wifijt/POE-Power-buck/docs/board_layers.png

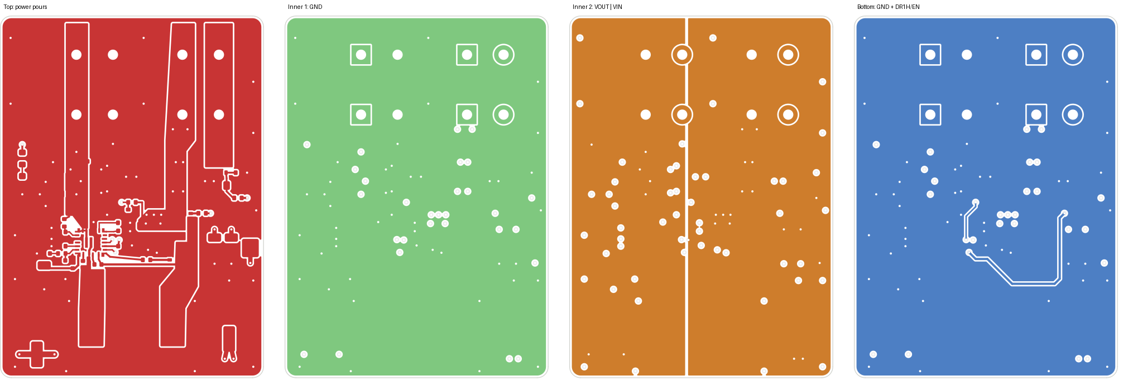
docs/board_layers.png
