wifijt/POE-Power-buck/fab/BOM_JLCPCB.csv

Comment | Designator | Footprint | JLCPCB Part # | MPN | Qty
100uF 35V polymer | C1,C20 | SMD,D6.3xL7.7mm | C46550467 | MA35V100M6X8 | 2
10uF 50V X5R | C2,C3,C4,C5 | 1206 | C13585 | CL31A106KBHNNNE | 4
100nF 50V | C7,C8,C9,C15,C21 | 0402 | C307331 | CL05B104KB54PNC | 5
10nF | C11,C12 | 0402 | C15195 | CL05B103KB5NNNC | 2
100pF C0G | C13 | 0402 | C1546 | 0402CG101J500NT | 1
22uF 25V | C14 | 1206 | C12891 | CL31A226KAHNNNE | 1
22uF 25V X7R | C16,C17,C18,C19 | 1210 | C21397 | GRM32ER71E226KE15L | 4
SMBJ16A | D1 | SMB(DO-214AA) | C19077571 | SMBJ16A | 1
GREEN | D2 | 0603 | C12624 | KT-0603G | 1
BZT52C12 | D3 | SOD-123 | C19077410 | BZT52C12 | 1
6.8uH 20A | L1 | SMD,13.5x12.8mm | C41422303 | ZEMS1265-6R8M | 1
CSD17577Q3A | Q1,Q2,Q3 | VSONP-8(3.3x3.3) | C201632 | CSD17577Q3A | 3
1R | R1,R2 | 0402 | C25086 | 0402WGF100KTCE | 2
100k | R3,R6,R13 | 0402 | C25741 | 0402WGF1003TCE | 3
28.7k | R4 | 0402 | C26972 | 0402WGF2872TCE | 1
49.9k | R5 | 0402 | C25897 | 0402WGF4992TCE | 1
11k | R7 | 0402 | C25749 | 0402WGF1102TCE | 1
22.1k | R9 | 0402 | C43473 | 0402WGF2212TCE | 1
15k | R10 | 0402 | C25756 | 0402WGF1502TCE | 1
4.7k | R11 | 0603 | C23162 | 0603WAF4701T5E | 1
10k | R12 | 0402 | C25744 | 0402WGF1002TCE | 1
TPS552882RPMR | U1 | VQFN-26-HR(4x3.5) | C3188898 | TPS552882RPMR | 1
