wifijt/POE-Power-buck/fab/BOM_hand_solder.csv

Designator | Part | Qty | Note
J1,J2 | WAGO 2604-3102 | 2 | 2-pole 5.0 mm lever terminal, solder by hand after PCBA
