wifijt/POE-Power-buck/enclosure/case_lid.stl

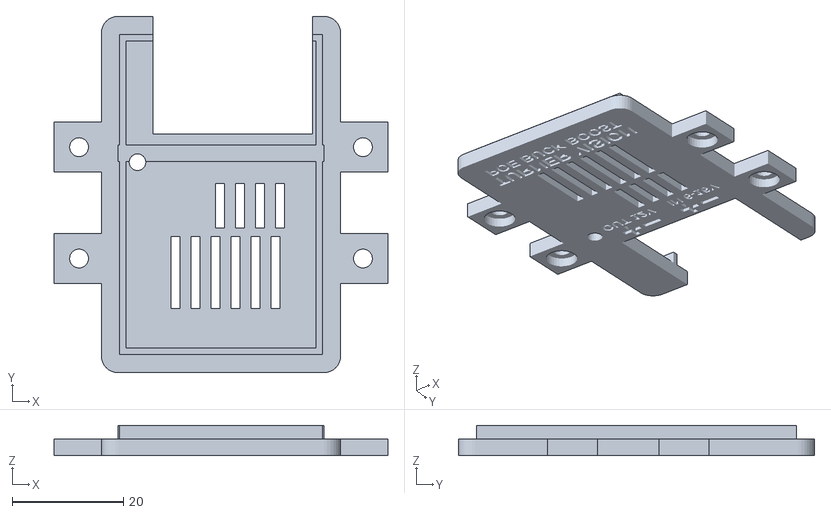
[picture p5: CAD file, 2026-11-11]
enclosure/case_lid.stl
60.0 x 64.0 x 5.40
