wifijt/POE-Power-buck/enclosure/case_tray.stl

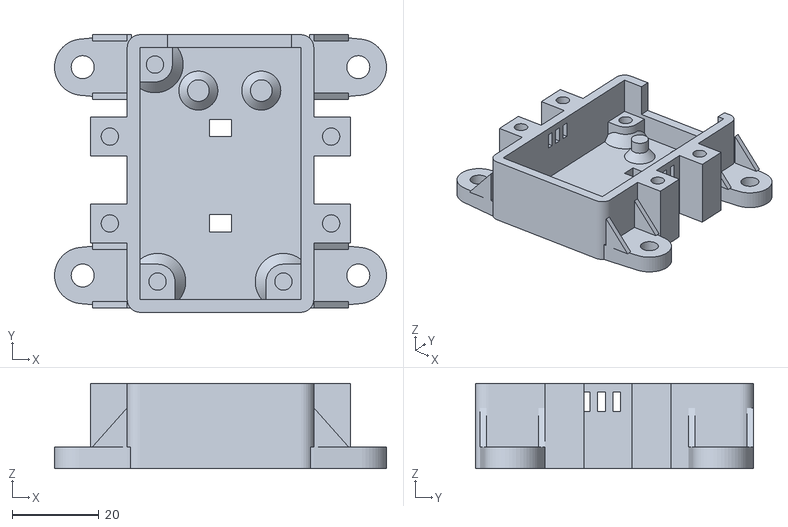
[picture p6: CAD file, 2026-11-11]
enclosure/case_tray.stl
76.5 x 64.0 x 19.6
