wifijt/POE-Power-buck/docs/schematic.pdf

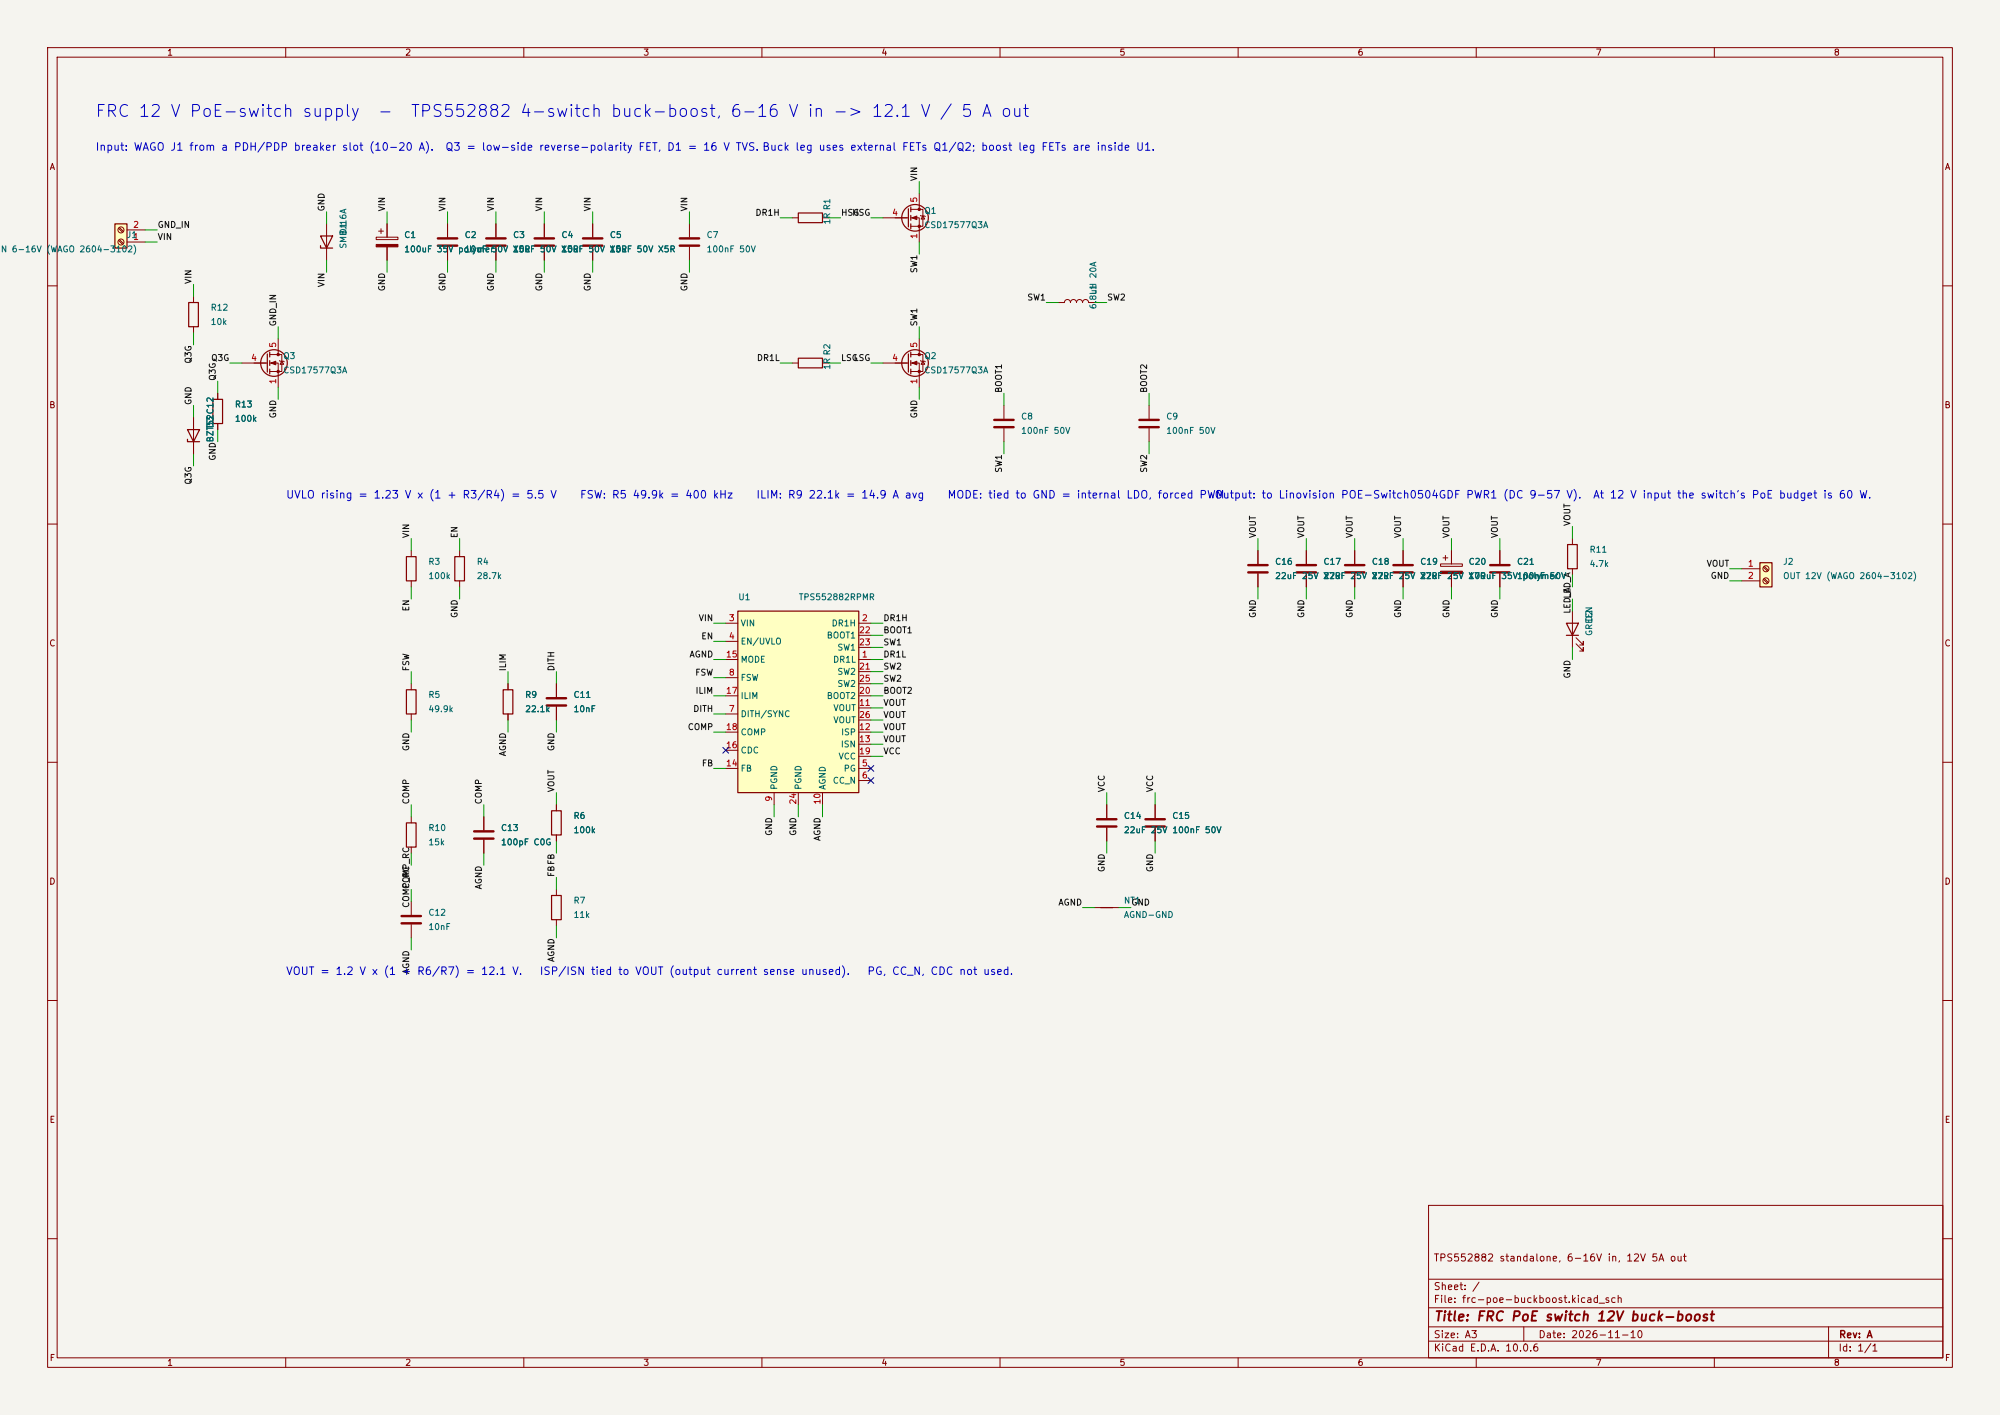
[picture p7: page 1]

FRC 12 V PoE-switch supply - TPS552882 4-switch buck-boost, 6-16 V in -> 12.1 V / 5 A out

Buck leg uses external FETs Q1/Q2; boost leg FETs are inside U1.

Sheet: /
File: frc-poe-buckboost.kicad_sch
Title: FRC PoE switch 12V buck-boost

Size: A3 | Rev: A | F Date: 2026-11-10
KiCad E.D.A. 10.0.6 | Id: 1/1
