wifijt/POE-Power-buck/frc-poe-buckboost.kicad_pcb

## KiCad design frc-poe-buckboost.kicad_pcb (2026-11-11)

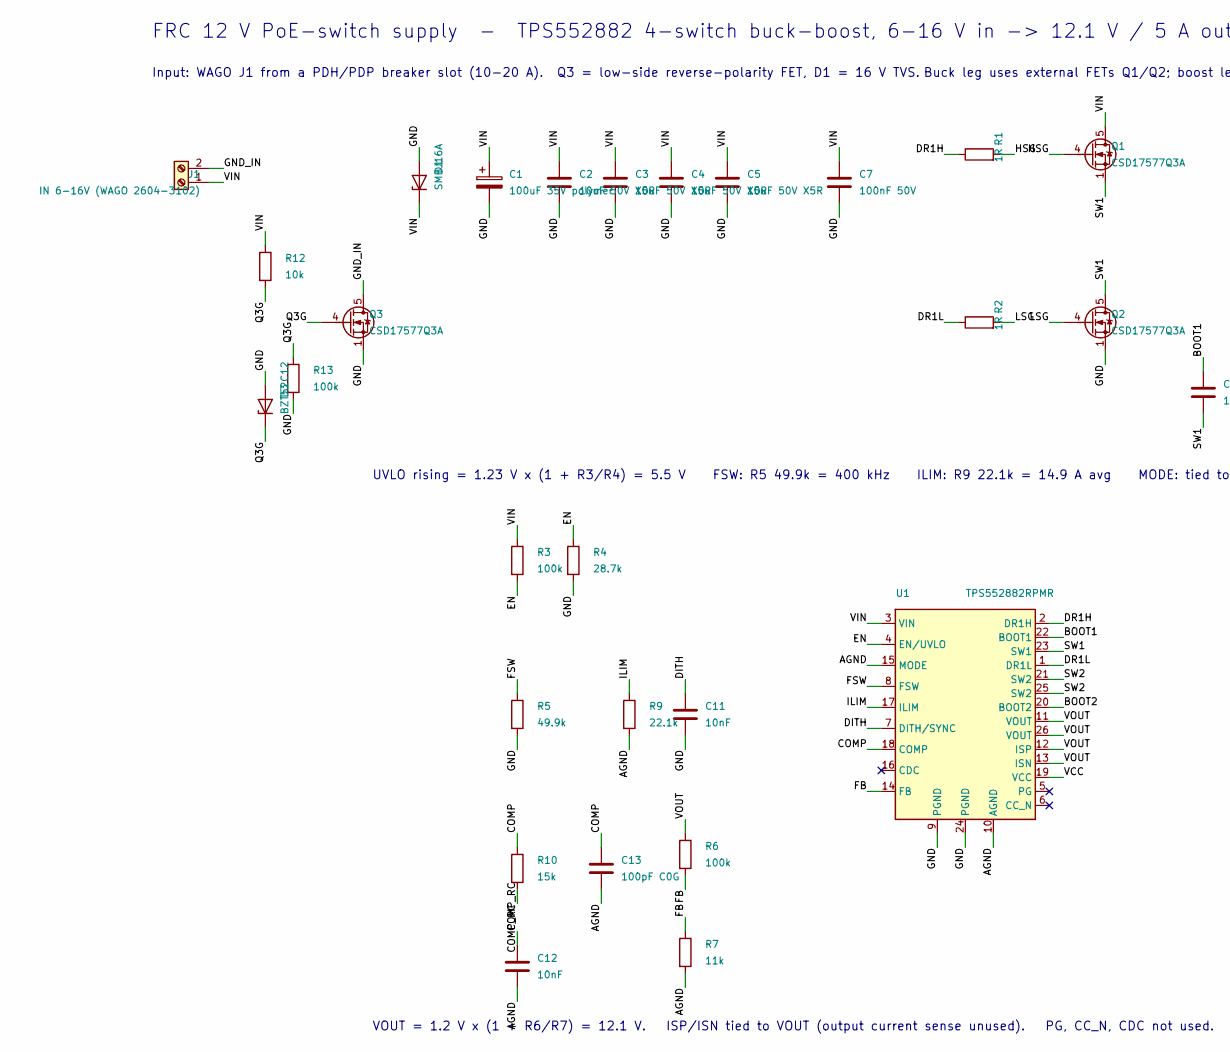
[picture p8: schematic frc-poe-buckboost.kicad_sch, FRC PoE switch 12V buck-boost, part in row 1, column 1]

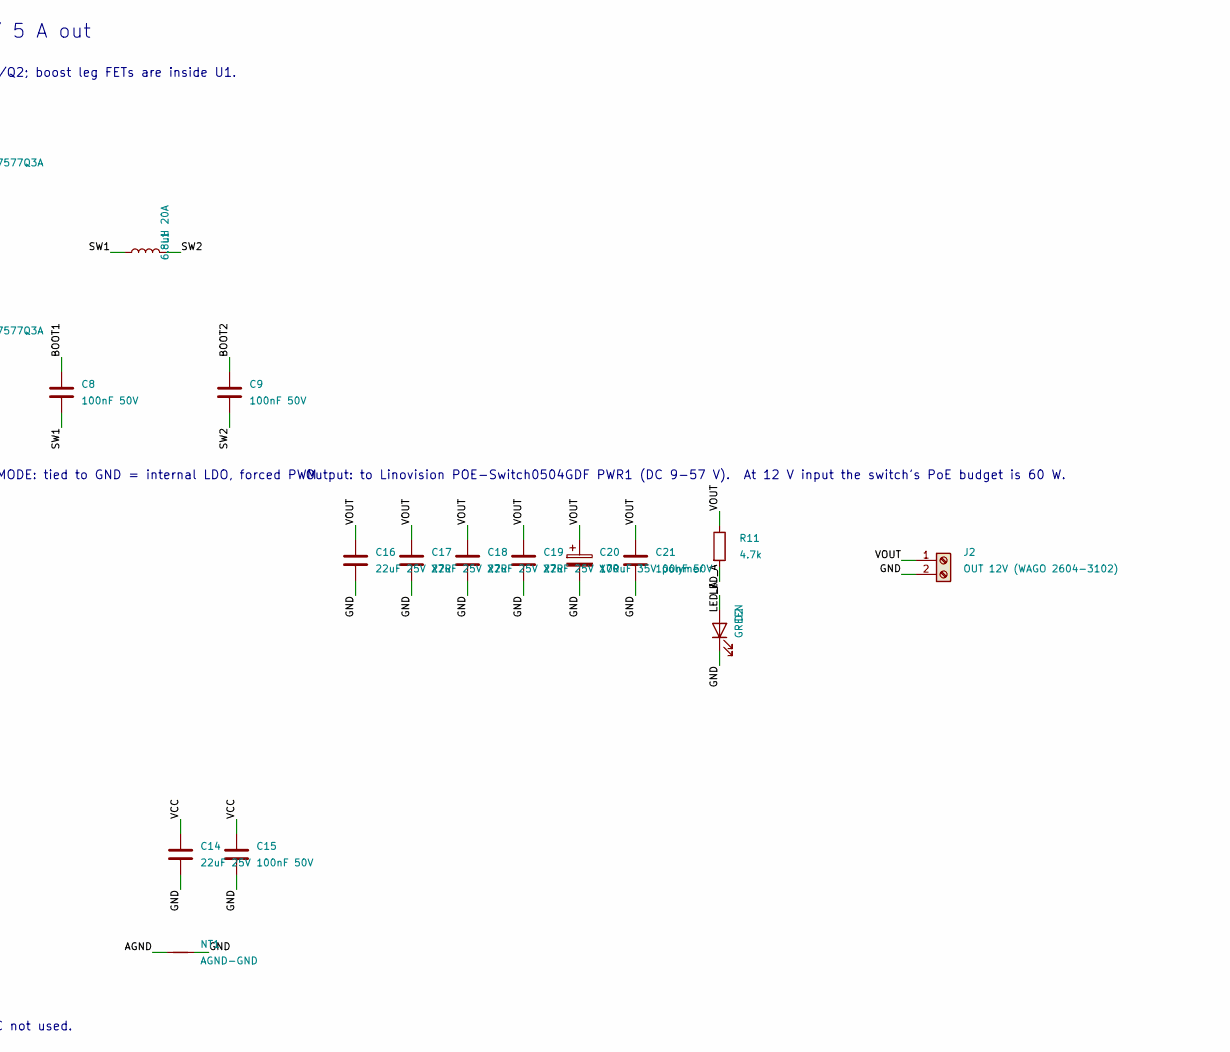
[picture p9: schematic frc-poe-buckboost.kicad_sch, FRC PoE switch 12V buck-boost, part in row 1, column 2]

Parts:
C1, C20: 100uF 35V polymer; CP_Elec_6.3x7.7; MPN MA35V100M6X8; LCSC C46550467
C2, C3, C4, C5: 10uF 50V X5R; C_1206_3216Metric; MPN CL31A106KBHNNNE; LCSC C13585
C7, C8, C9, C15, C21: 100nF 50V; C_0402_1005Metric; MPN CL05B104KB54PNC; LCSC C307331
C11, C12: 10nF; C_0402_1005Metric; MPN CL05B103KB5NNNC; LCSC C15195
C13: 100pF C0G; C_0402_1005Metric; MPN 0402CG101J500NT; LCSC C1546
C14: 22uF 25V; C_1206_3216Metric; MPN CL31A226KAHNNNE; LCSC C12891
C16, C17, C18, C19: 22uF 25V X7R; C_1210_3225Metric; MPN GRM32ER71E226KE15L; LCSC C21397
D1: SMBJ16A; D_SMB; MPN SMBJ16A; LCSC C19077571
D2: GREEN; LED_0603_1608Metric; MPN KT-0603G; LCSC C12624
D3: BZT52C12; D_SOD-123; MPN BZT52C12; LCSC C19077410
J1: IN 6-16V (WAGO 2604-3102); WAGO_2604-3102_1x02_P5.00mm; MPN WAGO 2604-3102
J2: OUT 12V (WAGO 2604-3102); WAGO_2604-3102_1x02_P5.00mm; MPN WAGO 2604-3102
L1: 6.8uH 20A; L_TaiTech_TMPC1265_13.5x12.5mm; MPN ZEMS1265-6R8M; LCSC C41422303
NT1: AGND-GND; NetTie-2_SMD_Pad0.5mm
Q1, Q2, Q3: CSD17577Q3A; NexFET_SON-8_3.3x3.3mm; MPN CSD17577Q3A; LCSC C201632
R1, R2: 1R; R_0402_1005Metric; MPN 0402WGF100KTCE; LCSC C25086
R3, R6, R13: 100k; R_0402_1005Metric; MPN 0402WGF1003TCE; LCSC C25741
R4: 28.7k; R_0402_1005Metric; MPN 0402WGF2872TCE; LCSC C26972
R5: 49.9k; R_0402_1005Metric; MPN 0402WGF4992TCE; LCSC C25897
R7: 11k; R_0402_1005Metric; MPN 0402WGF1102TCE; LCSC C25749
R9: 22.1k; R_0402_1005Metric; MPN 0402WGF2212TCE; LCSC C43473
R10: 15k; R_0402_1005Metric; MPN 0402WGF1502TCE; LCSC C25756
R11: 4.7k; R_0603_1608Metric; MPN 0603WAF4701T5E; LCSC C23162
R12: 10k; R_0402_1005Metric; MPN 0402WGF1002TCE; LCSC C25744
U1: TPS552882RPMR; TI_RPM0026A_VQFN-HR-26_4x3.5mm; MPN TPS552882RPMR; LCSC C3188898

Connections:
AGND: C12.2, C13.2, NT1.1, R7.2, R9.2, U1.10 (AGND), U1.15 (MODE)
BOOT1: C8.1, U1.22 (BOOT1)
BOOT2: C9.1, U1.20 (BOOT2)
COMP: C13.1, R10.1, U1.18 (COMP)
COMP_RC: C12.1, R10.2
DITH: C11.1, U1.7 (DITH/SYNC)
DR1H: R1.1, U1.2 (DR1H)
DR1L: R2.1, U1.1 (DR1L)
EN: R3.2, R4.1, U1.4 (EN/UVLO)
FB: R6.2, R7.1, U1.14 (FB)
FSW: R5.1, U1.8 (FSW)
GND: C1.2, C2.2, C3.2, C4.2, C5.2, C7.2, C11.2, C14.2, C15.2, C16.2, C17.2, C18.2, C19.2, C20.2, C21.2, D1.2 (A), D2.1 (K), D3.2 (A), J2.2, NT1.2, Q2.1 (S), Q2.2 (S), Q2.3 (S), Q3.1 (S), Q3.2 (S), Q3.3 (S), R4.2, R5.2, R13.2, U1.9 (PGND), U1.24 (PGND)
GND_IN: J1.2, Q3.5 (D)
HSG: Q1.4 (G), R1.2
ILIM: R9.1, U1.17 (ILIM)
LED_A: D2.2 (A), R11.2
LSG: Q2.4 (G), R2.2
Q3G: D3.1 (K), Q3.4 (G), R12.2, R13.1
SW1: C8.2, L1.1, Q1.1 (S), Q1.2 (S), Q1.3 (S), Q2.5 (D), U1.23 (SW1)
SW2: C9.2, L1.2, U1.21 (SW2), U1.25 (SW2)
VCC: C14.1, C15.1, U1.19 (VCC)
VIN: C1.1, C2.1, C3.1, C4.1, C5.1, C7.1, D1.1 (K), J1.1, Q1.5 (D), R3.1, R12.1, U1.3 (VIN)
VOUT: C16.1, C17.1, C18.1, C19.1, C20.1, C21.1, J2.1, R6.1, R11.1, U1.11 (VOUT), U1.12 (ISP), U1.13 (ISN), U1.26 (VOUT)

Notes on the sheet:
FRC 12 V PoE-switch supply - TPS552882 4-switch buck-boost, 6-16 V in -> 12.1 V / 5 A out
Input: WAGO J1 from a PDH/PDP breaker slot (10-20 A). Q3 = low-side reverse-polarity FET, D1 = 16 V TVS.
Buck leg uses external FETs Q1/Q2; boost leg FETs are inside U1.
UVLO rising = 1.23 V x (1 + R3/R4) = 5.5 V FSW: R5 49.9k = 400 kHz ILIM: R9 22.1k = 14.9 A avg MODE: tied to GND = internal LDO, forced PWM
VOUT = 1.2 V x (1 + R6/R7) = 12.1 V. ISP/ISN tied to VOUT (output current sense unused). PG, CC_N, CDC not used.
Output: to Linovision POE-Switch0504GDF PWR1 (DC 9-57 V). At 12 V input the switch's PoE budget is 60 W.

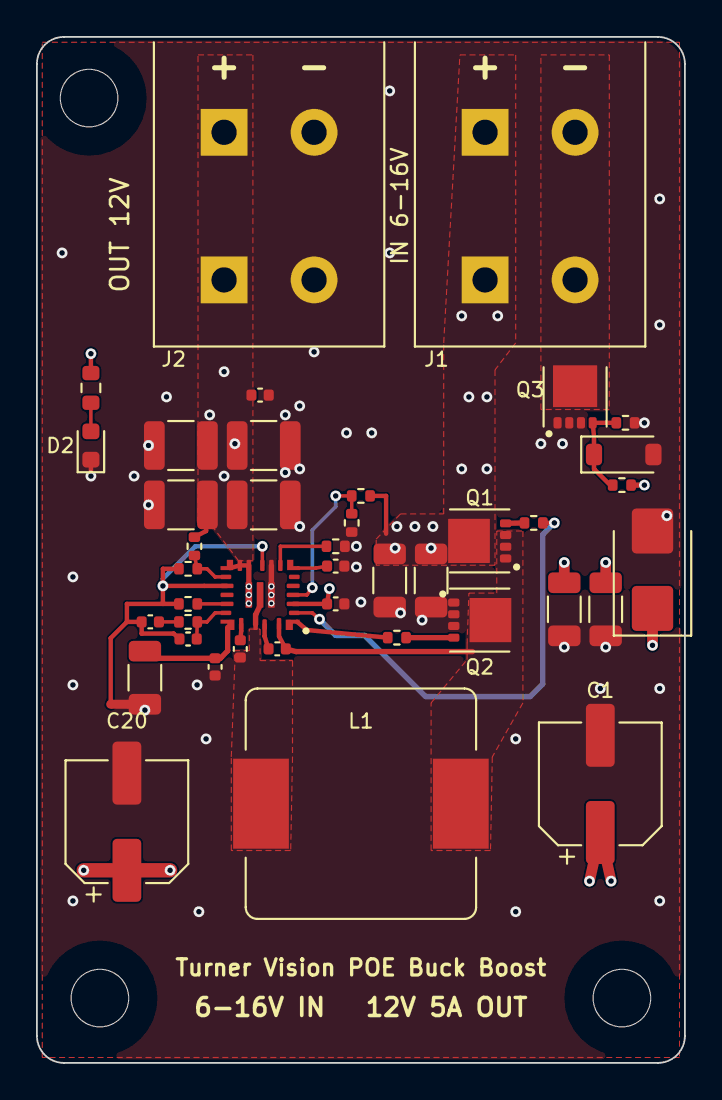
[picture p10: board frc-poe-buckboost.kicad_pcb from above]

Board: 4 copper layers, 36.0 x 57.0 mm, 45 parts (0 on the bottom side), 23 nets.

Other parts of the board:
H1, H2, H3: MountingHole_3.2mm_M3
