wifijt/POE-Power-buck/(commit log)

2026-11-11 FRC PoE-switch 12V buck-boost power board
    TPS552882 4-switch buck-boost, 6-16V FRC input -> 12V/5A for the
    Linovision POE-Switch0504GDF. 36 x 49.5 mm, 4-layer, WAGO 2604-3102
    lever terminals, low-side reverse-polarity FET + 16V TVS.
    KiCad 7 project generated from scripts/design.py; schematic, PCB and
    design nets cross-checked, DRC 0 unconnected / 0 clearance errors.
    Includes JLCPCB Gerbers, BOM and CPL.
    Claude-Session: https://claude.ai/code/session_015saaEFCQv6qCWnUWqYNrAW
    [BOM_JLCPCB.csv, BOM_hand_solder.csv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]
2026-11-11 Spec 2 oz outer copper for JLC; meet 2 oz spacing rules
    README: JLC order options now call for 2 oz outer copper (planned load
    ~40-55 W: two Pi 5s + Orange Pi 5 on PoE).
    Layout: design rules raised to 0.2 mm min track/clearance (JLC 2 oz
    limit); SW1 kelvin and VCC traces nudged to clear R2 and C9. DRC: 0
    unconnected, 0 clearance. Gerbers and preview regenerated.
    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
    [frc-poe-buckboost-B_Cu.gbl, frc-poe-buckboost-B_Mask.gbs, frc-poe-buckboost-B_Silkscreen.gbo, frc-poe-buckboost-Edge_Cuts.gm1, frc-poe-buckboost-F_Cu.gtl, frc-poe-buckboost-F_Mask.gts, frc-poe-buckboost-F_Paste.gtp, frc-poe-buckboost-F_Silkscreen.gto]
2026-11-11 JLC BOM: real LCSC part numbers, JLC-readable package names
    JLC's matcher read KiCad footprint names like C_0402_1005Metric as
    01005 and ignored the MPN column, so many lines matched wrong or
    out-of-stock parts. BOM now has a JLCPCB Part # for every line (from
    jlcpcb.com part pages) and plain package names (0402, 1206, SMB...).
    R6/R7 changed 102k/11.3k -> 100k/11k (common JLC parts); VOUT 12.1 V.
    C2-C5 now 10uF 50V X5R (C13585), C12 10nF X7R. Schematic, PCB, docs
    regenerated; nets re-checked, DRC 0 unconnected / 0 clearance.
    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
    [BOM_JLCPCB.csv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]
2026-11-11 Add tough 3D-printable case (tray + lid) for Prusa MK4
    OpenSCAD source plus ready-to-slice STLs. 3 mm walls, gusseted
    #10 mounting ears on a 2.5" (FRC 1/2" grid) spacing, M3 heat-set
    inserts for the lid, board held on a ledge and clamped by lid posts
    on parts-free edge spots. Open front over the WAGO terminals, lid
    cut-out over their levers, vents over the FETs/inductor, LED window.
    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
    [case.scad, case_lid.stl, case_tray.stl]
2026-11-11 Port generators to KiCad 10 on macOS; regenerate outputs
    - Find stock symbol/footprint libraries on macOS (or $KICAD_SHARE)
    - gen_sch: resolve 'extends' symbols; KiCad 10's CSD17577Q3A/CSD19537Q3
    are aliases with no pins, which left Q1-Q3 unconnected in the schematic
    - pcblib: MPN/LCSC footprint fields are hidden on F.Fab (KiCad 10 added
    them as visible F.SilkS text at each part origin)
    - fill_drc: run DRC via kicad-cli; pcbnew.WriteDRCReport segfaults outside the GUI
    - gen_pcb: KiCad 8+ default-netclass API; check_netlist: KiCad 8+ netlist layout
    - README: KiCad 10 / macOS regeneration steps
    Board geometry is unchanged from the KiCad 7 build (same placement, pad nets,
    tracks/vias; zone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
    [frc-poe-buckboost-B_Cu.gbl, frc-poe-buckboost-B_Mask.gbs, frc-poe-buckboost-B_Silkscreen.gbo, frc-poe-buckboost-Edge_Cuts.gm1, frc-poe-buckboost-F_Cu.gtl, frc-poe-buckboost-F_Mask.gts, frc-poe-buckboost-F_Paste.gtp, frc-poe-buckboost-F_Silkscreen.gto]
2026-11-11 Swap out-of-stock JLC parts; correct WAGO wire-entry description
    JLC's live BOM match (2026-11-11) showed 0 stock for two lines:
    - C1, C20: EEH-ZK1V101XP (C454360) -> MA35V100M6X8 (C46550467), 100uF 35V
    solid polymer, 30 mOhm, same 6.3x7.7 footprint, Economic-assembly OK
    - R9: CRCW040226K7FKEDC (C4198231) -> 0402WGF2672TCE (C25876), same 26.7k
    - R5: RC0402FR-0749K9L -> 0402WGF4992TCE (C25897), same 49.9k, Preferred
    Extended (no setup fee in Economic)
    WAGO 2604-3102 checked against WAGO's data sheet: pads, pitch, pin pair and
    drill match. The part takes wires vertically (90 deg to the PCB); the levers
    face -Y. Descriptions said "wire entry on -Y face"; geometry unchanged.
    Co-Authored-By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
    [BOM_JLCPCB.csv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]
2026-11-11 Check U1 against TI datasheet; fix ILIM and UVLO resistors
    Checked against TPS552882 datasheet SLVSFC5 (Nov 2020): all 26 pins and the
    RPM0026A land pattern match; FB, FSW, MODE, DITH, VCC and boot values are fine.
    - R9 ILIM 26.7k -> 22.1k (C43473). I_avg = 330000/R: 12.4 A typ but ~10.5 A
    min (-15%), below the ~11 A inductor current at 6 V in / 60 W out.
    Now 14.9 A typ, ~12.7 A min.
    - R4 UVLO 26.1k -> 28.7k (C26972). V_UVLO is 1.20-1.26 V, so 100k/26.1k
    could need 6.09 V to start. Now 5.5 V typ / 5.65 V max rising, ~5.0 V falling.
    - Schematic note said "MODE: R8 0R"; MODE is tied straight to GND.
    - README: datasheet findings, compensation margin note.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
    [BOM_JLCPCB.csv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]
2026-11-11 U1 grounding per TI layout guide: via-in-pad and AGND star point
    TI SLVSFC5 sec. 10.1 asks for thermal vias under U1 and for AGND to meet
    PGND only at the VCC capacitor.
    - U1 PGND bar (pad 24) and VOUT bar (pad 26) had no vias; each reached its
    plane only through a 0.3 mm trace to one edge pin. Added three 0.35/0.2 mm
    vias in each (PGND -> In1 GND, VOUT -> In2 VOUT). Needs JLC "epoxy filled
    & capped" and 0.2 mm min via hole; via annular rule set to 0.075 mm.
    - New AGND net: U1 AGND (pin 10, no longer bridged to PGND pin 9) and MODE,
    R7, R9, C12, C13. Routed as traces, joined to GND at C14's GND pad by
    net tie NT1 (not in BOM/CPL). Removed the five GND vias those parts used.
    R4/R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
    [frc-poe-buckboost-B_Cu.gbl, frc-poe-buckboost-B_Mask.gbs, frc-poe-buckboost-B_Silkscreen.gbo, frc-poe-buckboost-Edge_Cuts.gm1, frc-poe-buckboost-F_Cu.gtl, frc-poe-buckboost-F_Mask.gts, frc-poe-buckboost-F_Paste.gtp, frc-poe-buckboost-F_Silkscreen.gto]
2026-11-11 1 oz outer copper; gerber origin at board lower-left to match CPL
    - README: order with 1 oz outer copper. Inner VIN/VOUT/GND planes carry the
    main currents and the top-only runs are short. JLC's 2 oz plated-hole ring
    rule (0.254 mm) would put this board's vias in question.
    - Gerbers/drill were in KiCad page coordinates (board at X100-136,
    Y-149.5..-100) while the CPL is relative to the board's lower-left corner,
    so JLC flagged the parts as offset. Aux origin now sits at the lower-left
    corner; export with --use-drill-file-origin / --drill-origin plot.
    [frc-poe-buckboost-B_Cu.gbl, frc-poe-buckboost-B_Mask.gbs, frc-poe-buckboost-B_Silkscreen.gbo, frc-poe-buckboost-Edge_Cuts.gm1, frc-poe-buckboost-F_Cu.gtl, frc-poe-buckboost-F_Mask.gts, frc-poe-buckboost-F_Paste.gtp, frc-poe-buckboost-F_Silkscreen.gto]
2026-11-11 Add three M3 mounting holes and Turner Vision label
    - Board extended 7.5 mm at the bottom (36 x 57 mm); no parts moved.
    - M3 holes: top-left (2.9, 3.4) beside J2, bottom corners (3.5, 53.4) and
    (32.5, 53.4). Non-plated, copper keepout r = 3.3 mm on all layers so the
    power system stays isolated from the robot frame.
    - Front silkscreen: "Turner Vision POE Buck Boost" / "6-16V IN 12V 5A OUT".
    "OUT 12V" moved down to clear the top-left hole.
    - gen_fab: CPL origin from the board's aux origin (same as the gerbers);
    mounting holes left out of the CPL.
    - README: board size, mounting holes, new top render.
    [CPL_JLCPCB.csv, frc-poe-buckboost-B_Cu.gbl, frc-poe-buckboost-B_Mask.gbs, frc-poe-buckboost-B_Silkscreen.gbo, frc-poe-buckboost-Edge_Cuts.gm1, frc-poe-buckboost-F_Cu.gtl, frc-poe-buckboost-F_Mask.gts, frc-poe-buckboost-F_Paste.gtp]
2026-11-11 CPL: rotate C1/C20 180 deg for JLC; README D1 pre-power check
    Checked every polarized part in JLC's placement preview: U1, Q1-Q3 and
    D1-D3 match KiCad at 0 deg; the CP_Elec_6.3x7.7 caps (C1, C20) had JLC's +
    on the wrong pad. gen_fab.py applies a per-footprint JLC_ROT correction.
    README: rotation-check note in the ordering steps, and a diode-mode check
    that the D1 TVS isn't reversed before first power-up.
    [CPL_JLCPCB.csv]
2026-11-11 Case: fit 36 x 57 mm board, hold it on three M3 standoffs
    The case was sized for the old 36 x 49.5 mm board and clamped its edges
    with lid posts. Now:
    - 3 standoffs under the board's M3 holes (8 mm top, 13 mm flared foot,
    fused into the walls), M3 heat-set insert in each; board screws down.
    - 2 pillars under the WAGO terminals (0.15 mm below the board) take
    lever/wire-insertion force; the terminals take wires vertically.
    - 3 mm walls/floor/lid, 4 lid screws (was 2), stiffening rib by the
    terminal opening, lid lip 1.2 mm to clear C1.
    - 4 braced mounting ears (was 2, both at one end), #10 on the 1/2" grid.
    - STLs re-exported (OpenSCAD 2026.10.11), README and print layout updated.
    Co-Aut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
    [case.scad, case_lid.stl, case_tray.stl]
2026-11-11 Case lid: engraved polarity marks, terminal names and branding
    +/- marks sit directly behind each WAGO opening, over the poles (OUT: VOUT
    at board x 10.4, GND at 15.4; IN: VIN at 24.9, GND_IN at 29.9), with
    "OUT 12V" / "IN 6-16V" below and "TURNER VISION / POE BUCK BOOST" at the
    back. FET vent group moved back 2 mm to make room. Replaces "12V PoE".
    Claude-Session: https://claude.ai/code/session_015saaECZ3ZXNcue8ZbAJvbz
    [case.scad, case_lid.stl]
